Silbstep/Scale/Documents/LCD/AN 339 FT800 Single JPEG Viewer/Test/Glasgow.jpg

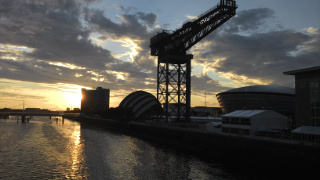
Documents/LCD/AN 339 FT800 Single JPEG Viewer/Test/Glasgow.jpg
