Silbstep/Scale/(list of files, cad)

Other CAD files:
Documents/LCD/ER-TFT035-6(8080-8-Bit)_TP_SD_DemoCode/sd.OBJ
