Silbstep/Scale/Documents/Ethernet/MI0805K601R-10.pdf

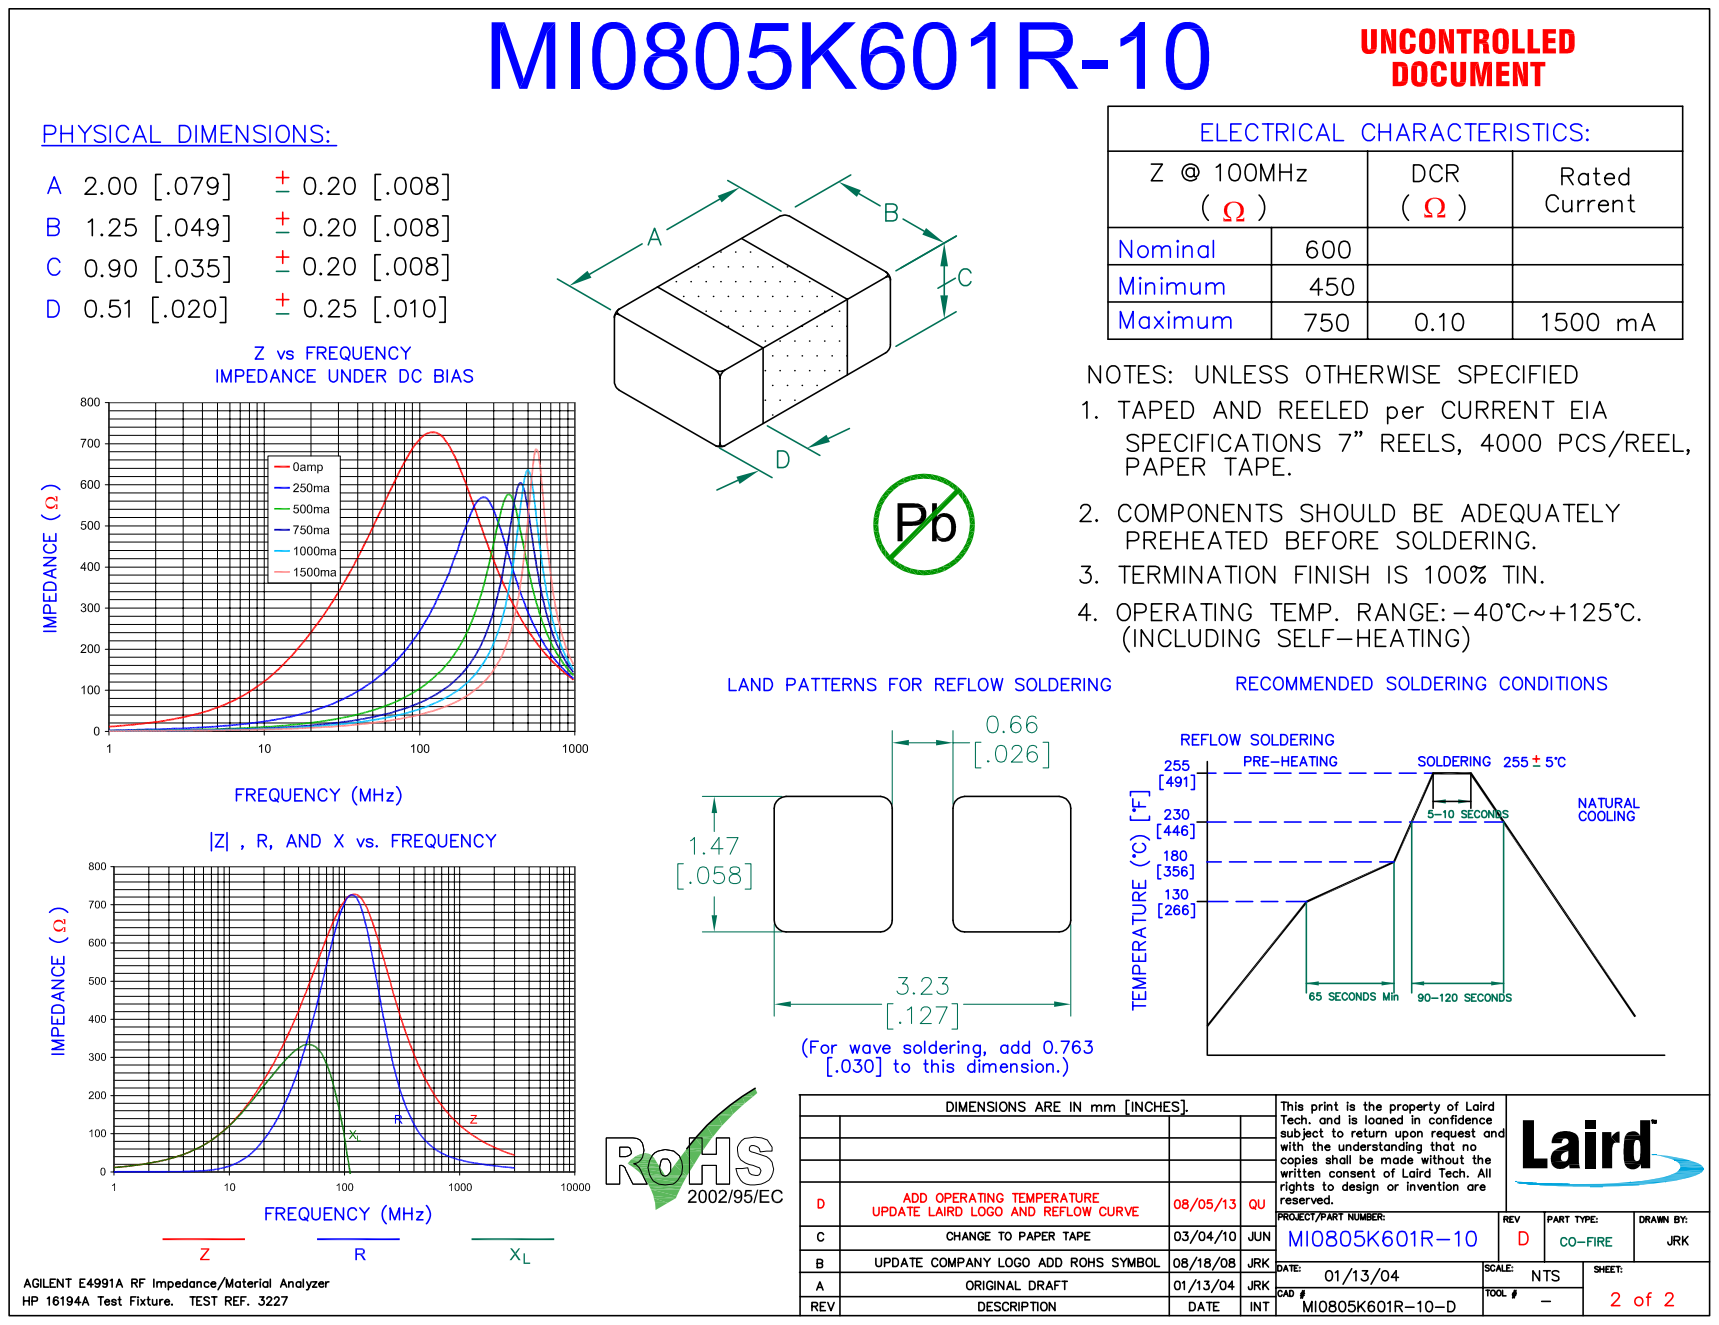
[picture p2: page 1]
