Silbstep/Scale/Documents/Ethernet/SI-16001-F.pdf

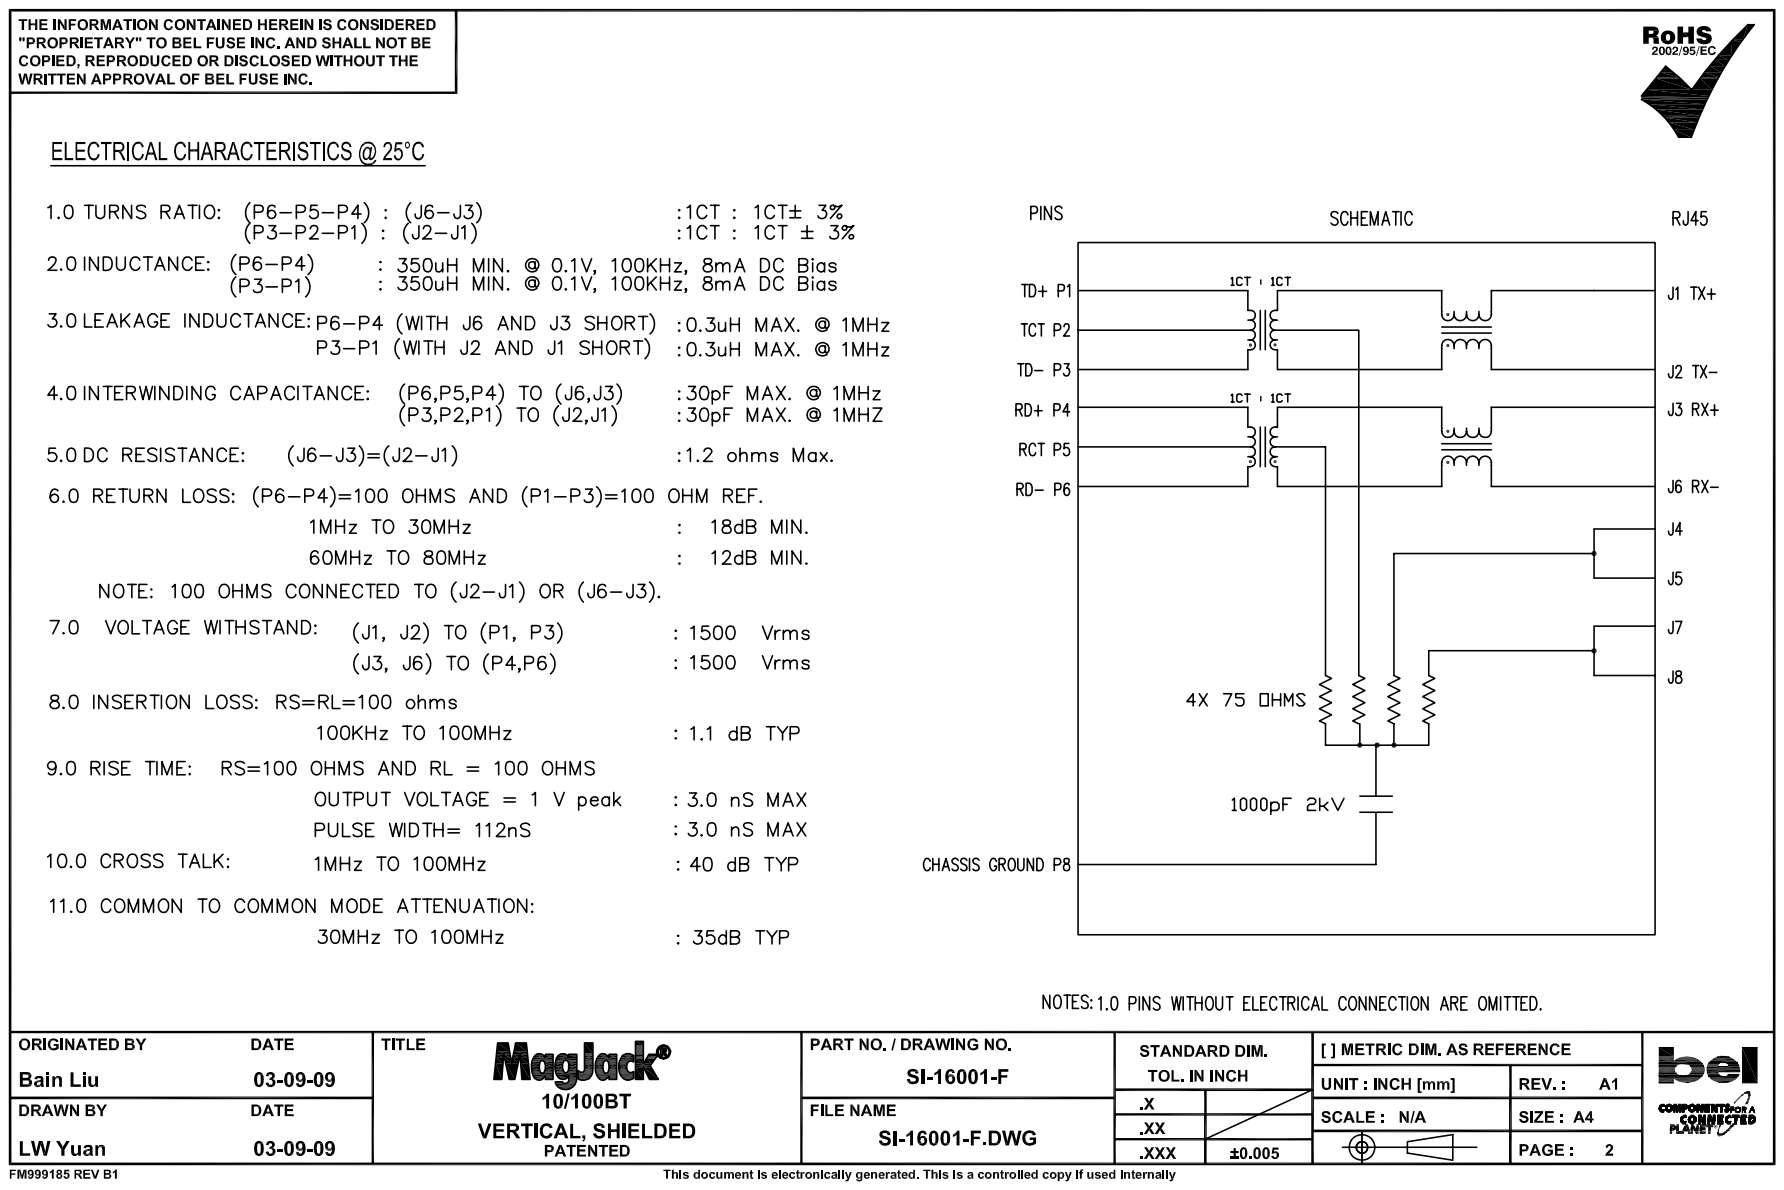
[picture p7: page 1]

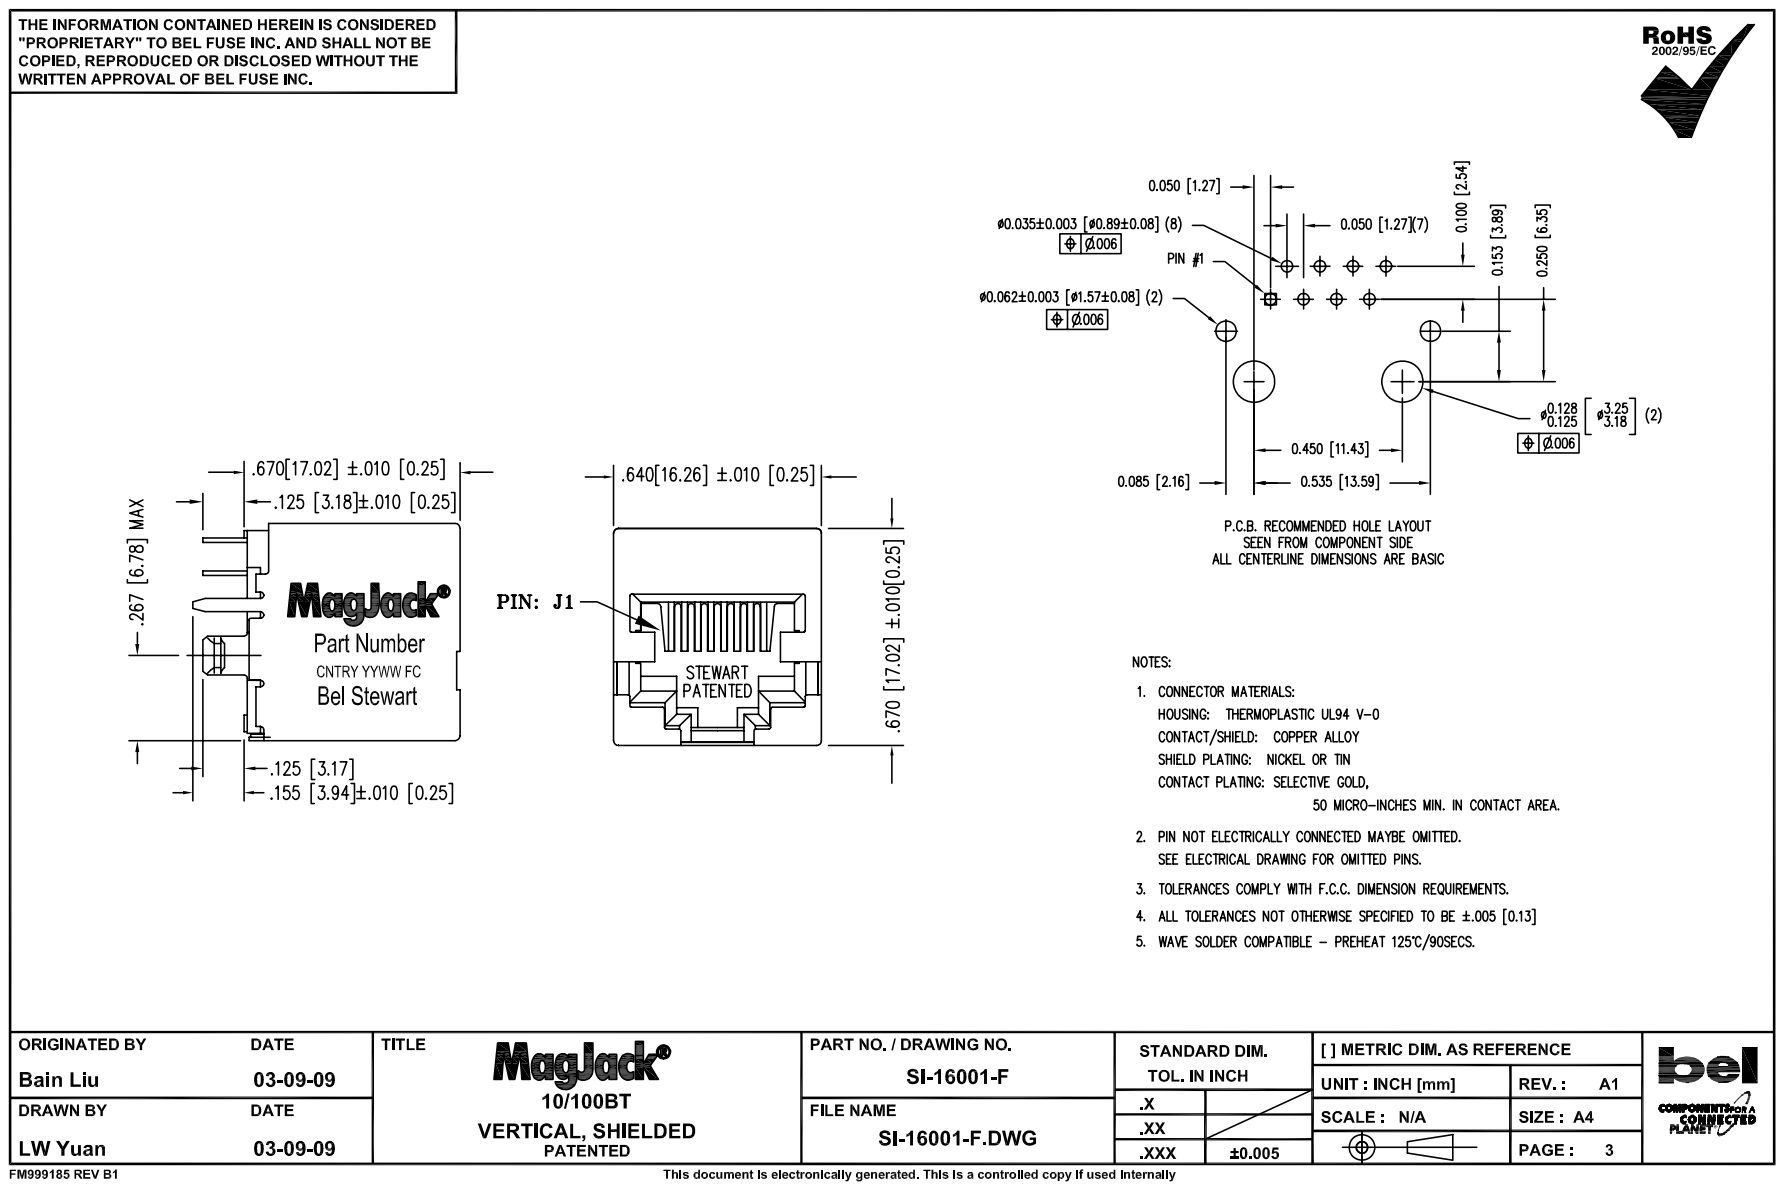
[picture p8: page 2]
