Silbstep/Scale/Hardware/Scale.kicad_pcb

## KiCad design Hardware/Scale.kicad_pcb (2023-03-06)

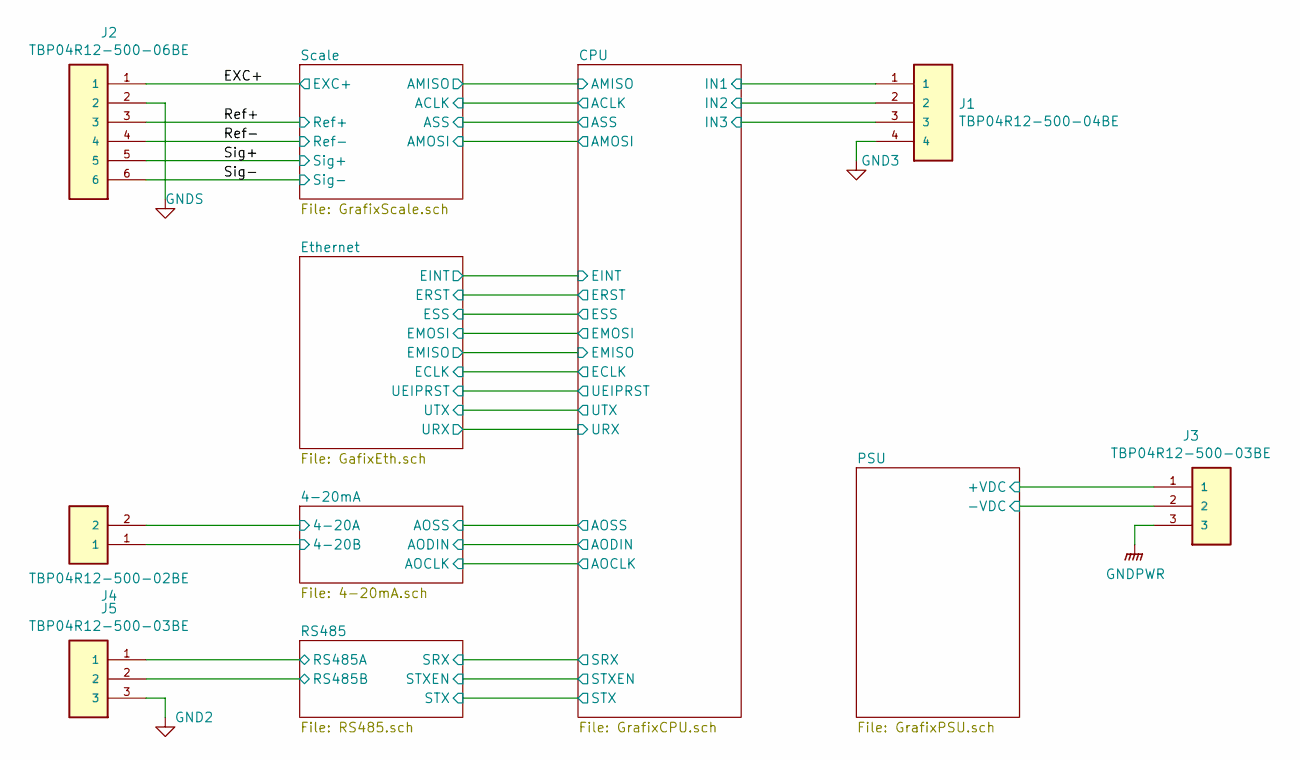
[picture p9: schematic Scale.sch]

Parts:
J1: TBP04R12-500-04BE; MPN TBP04R12-500-04BE
J2: TBP04R12-500-06BE; MPN TBP04R12-500-06BE
J3, J5: TBP04R12-500-03BE; MPN TBP04R12-500-03BE
J4: TBP04R12-500-02BE; MPN TBP04R12-500-02BE

Connections:
/4-20mA/4-20A: J4.2; also elsewhere on the board
/4-20mA/4-20B: J4.1; also elsewhere on the board
/CPU/IN1: J1.1; also elsewhere on the board
/CPU/IN2: J1.2; also elsewhere on the board
/CPU/IN3: J1.3; also elsewhere on the board
/EXC+: J2.1; also elsewhere on the board
/PSU/+VDC: J3.1; also elsewhere on the board
/PSU/-VDC: J3.2; also elsewhere on the board
/RS485/RS485A: J5.1; also elsewhere on the board
/RS485/RS485B: J5.2; also elsewhere on the board
/Ref+: J2.3; also elsewhere on the board
/Ref-: J2.4; also elsewhere on the board
/Sig+: J2.5; also elsewhere on the board
/Sig-: J2.6; also elsewhere on the board
GND2: J5.3; also elsewhere on the board
GND3: J1.4; also elsewhere on the board
GNDPWR: J3.3; also elsewhere on the board
GNDS: J2.2; also elsewhere on the board

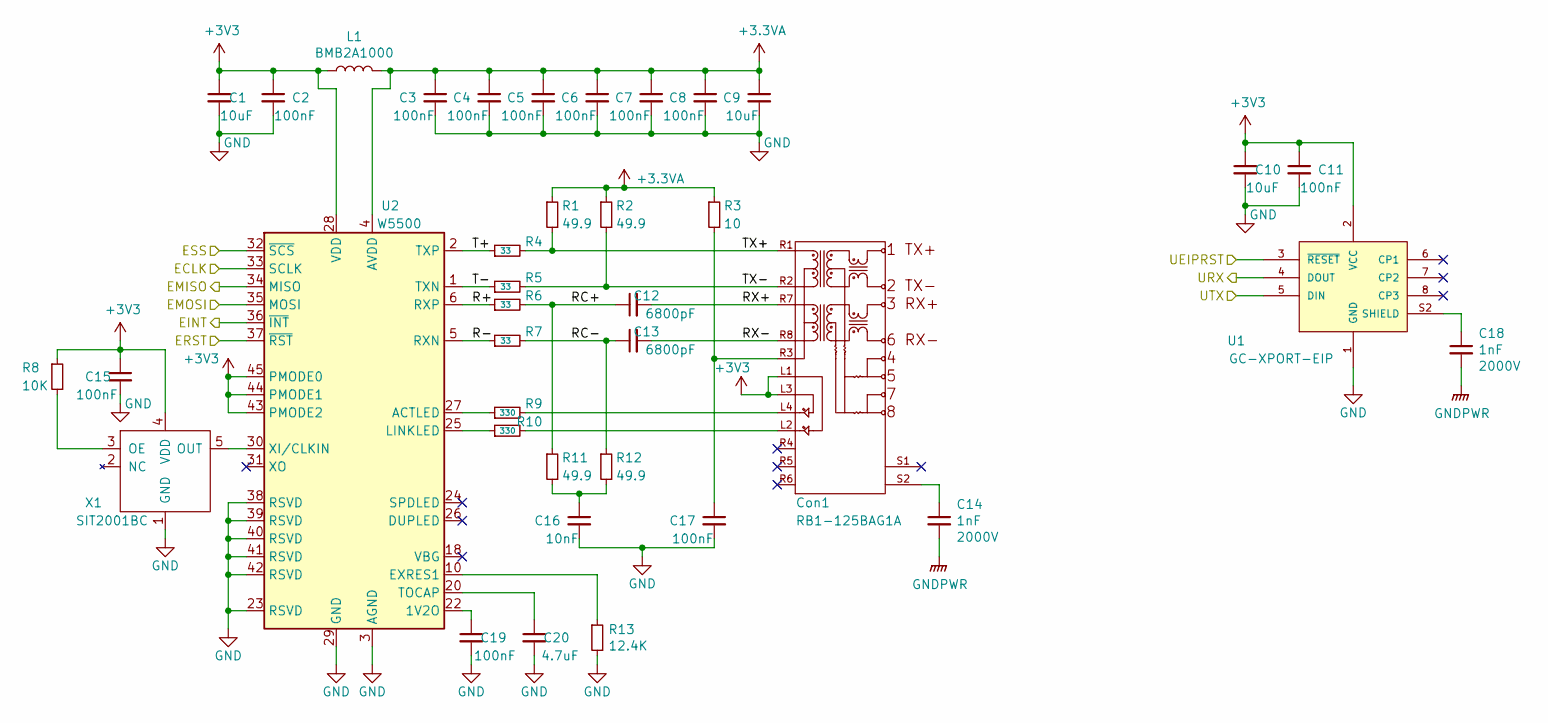
[picture p10: schematic GafixEth.sch]

Parts:
C1, C9, C10: 10uF; C_0603_1608Metric
C2, C3, C4, C5, C6, C7, C8, C11, C15, C17, C19: 100nF; C_0603_1608Metric
C12, C13: 6800pF; C_0603_1608Metric
C14, C18: 1nF; C_1206_3216Metric
C16: 10nF; C_0603_1608Metric
C20: 4.7uF; C_0603_1608Metric
Con1: RB1-125BAG1A; MPN RB1-125BAG1A
L1: BMB2A1000; L_0805_2012Metric; MPN BMB2A1000LN2
R1, R2, R11, R12: 49.9; R_0603_1608Metric
R3: 10; R_0603_1608Metric
R4, R5, R6, R7: 33; R_0603_1608Metric
R8: 10K; R_0603_1608Metric
R9, R10: 330; R_0603_1608Metric
R13: 12.4K; R_0603_1608Metric
U1: GC-XPORT-EIP; XPORT; MPN GC-XPORT-EIP-MB
U2: W5500; MPN W5500
X1: SIT2001BC; SOT-753; MPN SIT2001BC-S2-33E-25.000000

Connections:
+3.3VA: C3.1, C4.1, C5.1, C6.1, C7.1, C8.1, C9.1, L1.2, R1.1, R2.1, R3.1, U2.4 (AVDD), U2.8 (AVDD), U2.11 (AVDD), U2.15 (AVDD), U2.17 (AVDD), U2.21 (AVDD)
/CPU/ECLK: U2.33 (SCLK); also elsewhere on the board
/CPU/EINT: U2.36 (~INT); also elsewhere on the board
/CPU/EMISO: U2.34 (MISO); also elsewhere on the board
/CPU/EMOSI: U2.35 (MOSI); also elsewhere on the board
/CPU/ERST: U2.37 (~RST); also elsewhere on the board
/CPU/ESS: U2.32 (~SCS); also elsewhere on the board
/CPU/UEIPRST: U1.3 (~RESET); also elsewhere on the board
/CPU/URX: U1.4 (DOUT); also elsewhere on the board
/CPU/UTX: U1.5 (DIN); also elsewhere on the board
/Ethernet/R+: R6.1, U2.6 (RXP)
/Ethernet/R-: R7.1, U2.5 (RXN)
/Ethernet/RC+: C12.1, R6.2, R11.1
/Ethernet/RC-: C13.1, R7.2, R12.1
/Ethernet/RX+: C12.2, Con1.R7
/Ethernet/RX-: C13.2, Con1.R8
/Ethernet/T+: R4.1, U2.2 (TXP)
/Ethernet/T-: R5.1, U2.1 (TXN)
/Ethernet/TX+: Con1.R1, R1.2, R4.2
/Ethernet/TX-: Con1.R2, R2.2, R5.2
GND: C1.2, C2.2, C3.2, C4.2, C5.2, C6.2, C7.2, C8.2, C9.2, C10.2, C11.2, C15.2, C16.2, C17.2, C19.2, C20.2, R13.2, U1.1 (GND), U2.3 (AGND), U2.9 (AGND), U2.14 (AGND), U2.16 (AGND), U2.19 (AGND), U2.23 (RSVD), U2.29 (GND), U2.38 (RSVD), U2.39 (RSVD), U2.40 (RSVD), U2.41 (RSVD), U2.42 (RSVD), U2.48 (AGND), X1.1 (GND); also elsewhere on the board
GNDPWR: C14.2, C18.2; also elsewhere on the board
unnamed: C14.1, Con1.S2
unnamed: C16.1, R11.2, R12.2
unnamed: C17.1, Con1.R3, R3.2
unnamed: C18.1, U1.S2 (SHIELD)
unnamed: C19.1, U2.22 (1V2O)
unnamed: C20.1, U2.20 (TOCAP)
unnamed: Con1.L2, R10.2
unnamed: Con1.L4, R9.2
unnamed: R8.2, X1.3 (OE)
unnamed: R9.1, U2.27 (ACTLED)
unnamed: R10.1, U2.25 (LINKLED)
unnamed: R13.1, U2.10 (EXRES1)
unnamed: U2.30 (XI/CLKIN), X1.5 (OUT)

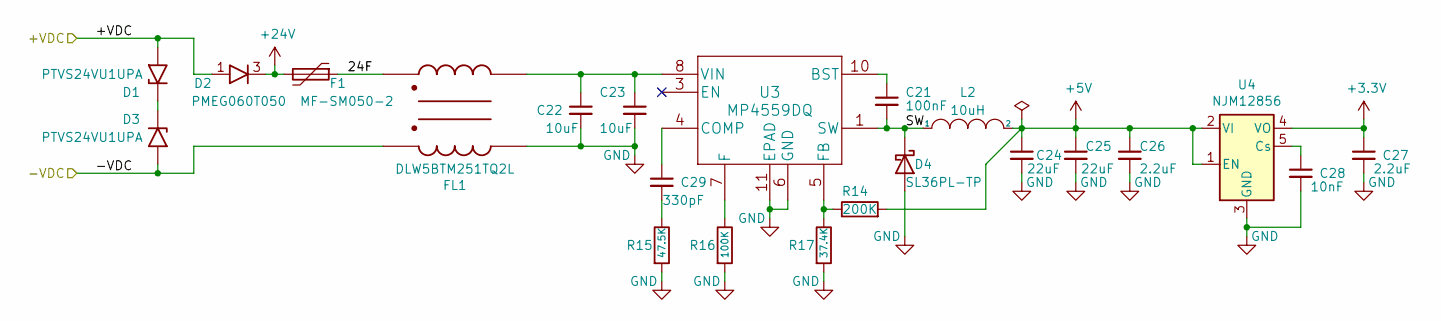
[picture p11: schematic GrafixPSU.sch]

Parts:
C21: 100nF; C_0603_1608Metric
C22, C23: 10uF; C_1206_3216Metric; MPN CL31B106KBHNNNE
C24, C25: 22uF; C_1206_3216Metric
C26, C27: 2.2uF; C_0603_1608Metric
C28: 10nF; C_0603_1608Metric
C29: 330pF; C_0603_1608Metric
D1, D3: PTVS24VU1UPA; PTVS10VU1UPAZ; MPN PTVS24VU1UPAZ
D2: PMEG060T050; TO-277; MPN PMEG060T050ELPEZ
D4: SL36PL-TP; SOD123-FL; MPN SL36PL-TP
F1: MF-SM050-2; MF-SM050; MPN MF-SM050-2
FL1: DLW5BTM251TQ2L; MPN DLW5BTM251TQ2L
L2: 10uH; MPL-SE6040; MPN MPL-SE6040-100
R14: 200K; R_0603_1608Metric
R15: 47.5K; R_0603_1608Metric
R16: 100K; R_0603_1608Metric
R17: 37.4K; R_0603_1608Metric
U3: MP4559DQ; DFN-10-1EP_3x3mm_P0.5mm_EP1.7x2.5mm; MPN MP4559DQ-LF-Z
U4: NJM12856; TO-252-5_TabPin6; MPN NJM12856DL3-33-TE1

Connections:
+5V: C24.1, C25.1, C26.1, L2.2, R14.2, U4.1 (EN), U4.2 (VI); also elsewhere on the board
+24V: D2.3 (K), F1.2
/PSU/24F: F1.1, FL1.4
/PSU/+VDC: D1.1 (A1), D1.2 (A2), D2.1 (A), D2.2 (A); also elsewhere on the board
/PSU/-VDC: D3.1 (A1), D3.2 (A2), FL1.1; also elsewhere on the board
GND: C22.2, C23.2, C24.2, C25.2, C26.2, C27.2, C28.2, D4.2 (A), FL1.2, R15.2, R16.2, R17.2, U3.6 (GND), U3.11 (EPAD), U4.3 (GND), U4.6 (GND); also elsewhere on the board
unnamed: C21.1, U3.10 (BST)
unnamed: C28.1, U4.5 (Cs)
unnamed: C29.1, U3.4 (COMP)
unnamed: C29.2, R15.1
unnamed: D1.3 (K1), D1.4 (K2), D3.3 (K1), D3.4 (K2)
unnamed: R14.1, R17.1, U3.5 (FB)
unnamed: R16.1, U3.7 (F)
SW: C21.2, D4.1 (K), L2.1, U3.1 (SW), U3.2 (SW)
VIN: C22.1, C23.1, FL1.3, U3.8 (VIN), U3.9 (VIN)

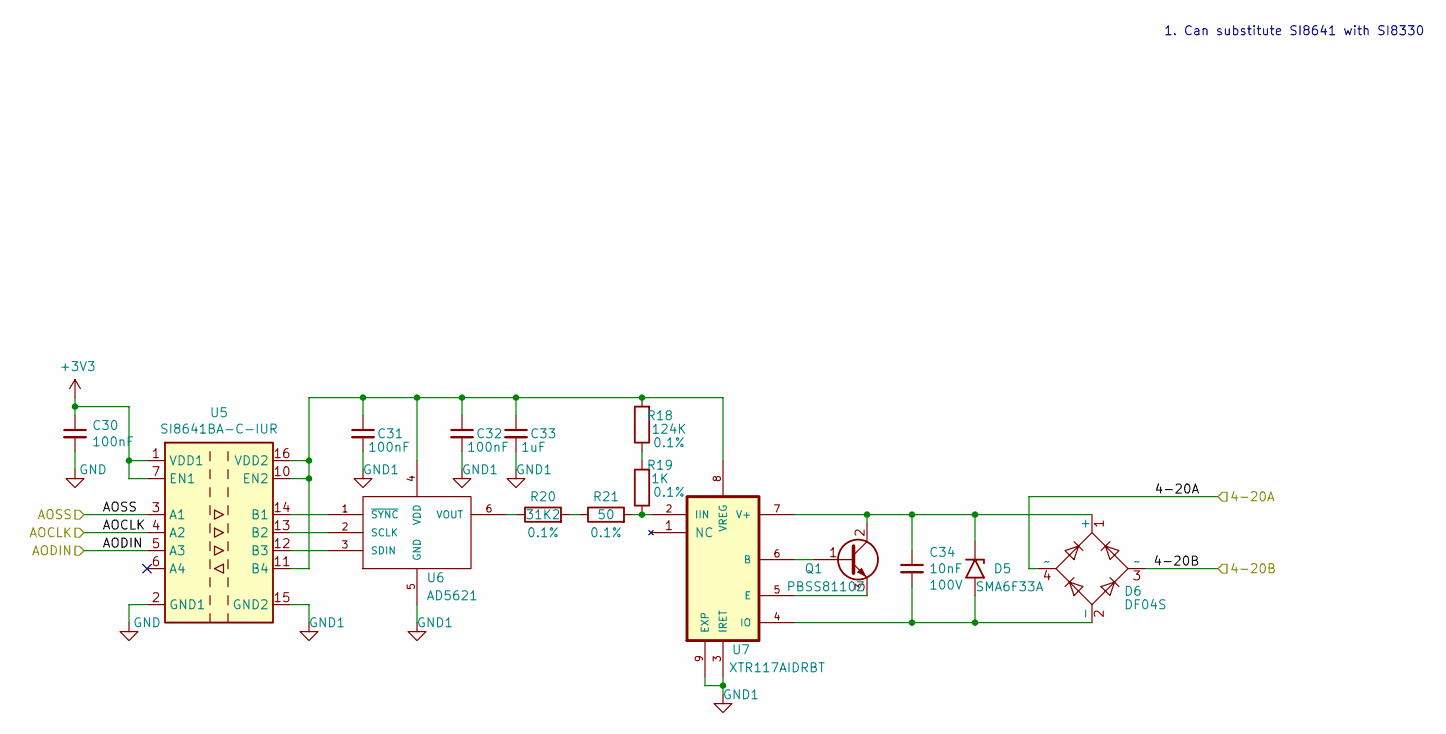
[picture p12: schematic 4-20mA.sch]

Parts:
C30, C31, C32: 100nF; C_0603_1608Metric
C33: 1uF; C_0603_1608Metric
C34: 10nF; C_0805_2012Metric; Voltage 100V
D5: SMA6F33A; DO221AC; MPN SMA6F33A-M3/H
D6: DF04S; MPN DF04S
Q1: PBSS8110Z; SOT-223; MPN PBSS8110Z,135
R18: 124K; R_0603_1608Metric; Tolerance 0.1%
R19: 1K; R_0603_1608Metric; Tolerance 0.1%
R20: 31K2; R_0603_1608Metric; Tolerance 0.1%
R21: 50; R_0603_1608Metric; Tolerance 0.1%
U5: SI8641BA-C-IUR; QSOP-16_3.9x4.9mm_P0.635mm; MPN SI8641BA-C-IUR
U6: AD5621; SOT-363_SC-70-6; MPN AD5621AKSZ-REEL7
U7: XTR117AIDRBT; XTR117AID; MPN XTR117AIDRBT

Connections:
/4-20mA/4-20A: D6.4 (~~); also elsewhere on the board
/4-20mA/4-20B: D6.3 (~~); also elsewhere on the board
/4-20mA/AOCLK: U5.4 (A2); also elsewhere on the board
/4-20mA/AODIN: U5.5 (A3); also elsewhere on the board
/4-20mA/AOSS: U5.3 (A1); also elsewhere on the board
GND: C30.2, U5.2 (GND1), U5.8 (GND1); also elsewhere on the board
GND1: C31.2, C32.2, C33.2, U5.9 (GND2), U5.15 (GND2), U6.5 (GND), U7.3 (IRET), U7.9 (EXP)
unnamed: C31.1, C32.1, C33.1, R18.2, U5.10 (EN2), U5.11 (B4), U5.16 (VDD2), U6.4 (VDD), U7.8 (VREG)
unnamed: C34.1, D5.1 (A1), D6.1 (+), Q1.2 (C), Q1.4 (C), U7.7 (V+)
unnamed: C34.2, D5.2 (A2), D6.2 (-), U7.4 (IO)
unnamed: Q1.1 (B), U7.6 (B)
unnamed: Q1.3 (E), U7.5 (E)
unnamed: R18.1, R19.2
unnamed: R19.1, R21.2, U7.2 (IIN)
unnamed: R20.1, U6.6 (VOUT)
unnamed: R20.2, R21.1
unnamed: U5.12 (B3), U6.3 (SDIN)
unnamed: U5.13 (B2), U6.2 (SCLK)
unnamed: U5.14 (B1), U6.1 (~SYNC)

Notes on the sheet:
1. Can substitute SI8641 with SI8330

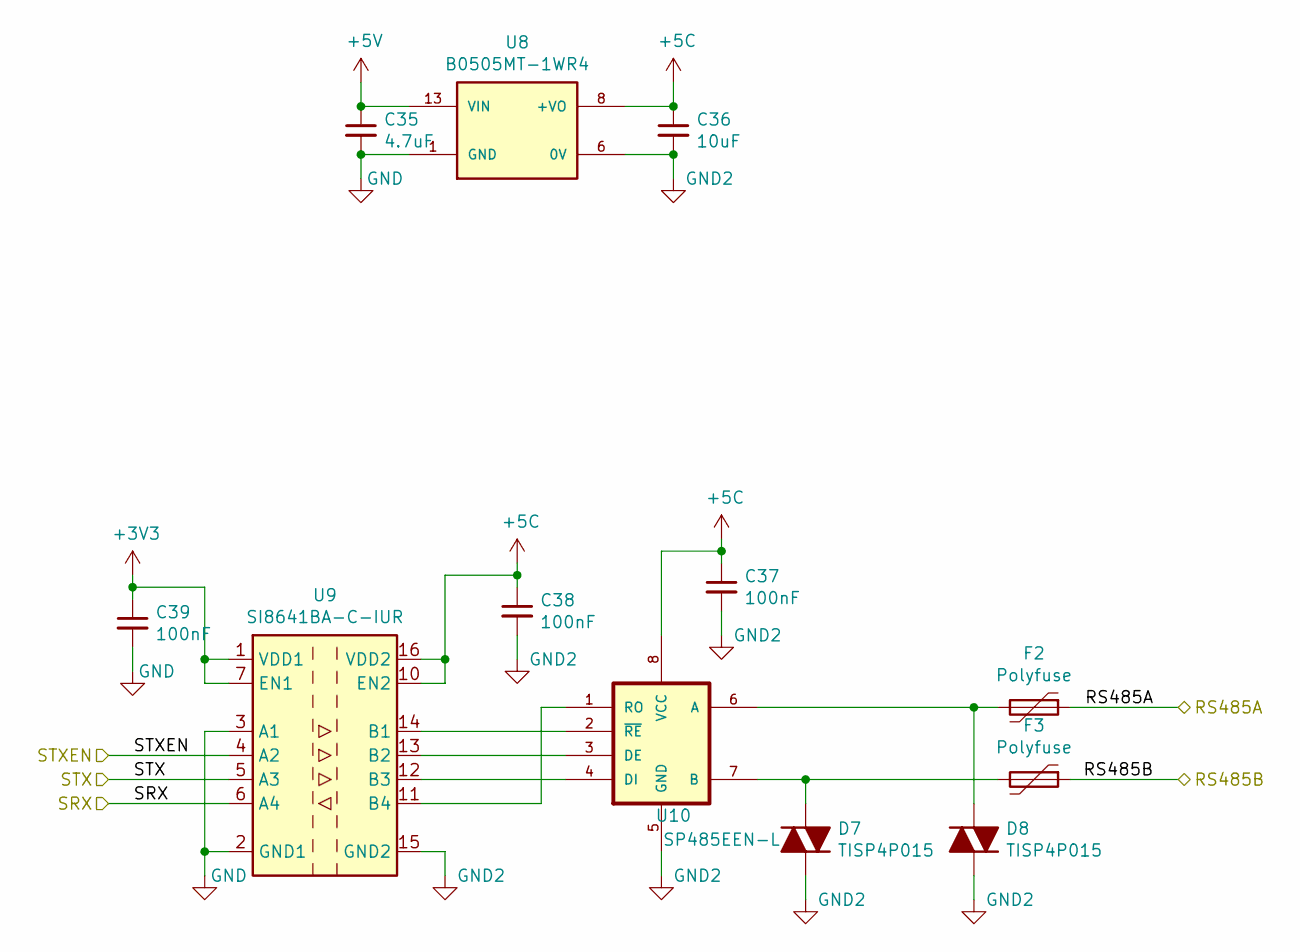
[picture p13: schematic RS485.sch]

Parts:
C35: 4.7uF; C_0603_1608Metric
C36: 10uF; C_0603_1608Metric
C37, C38, C39: 100nF; C_0603_1608Metric
D7, D8: TISP4P015; SOT-23-5; MPN TISP4P015L1NR-S
F2, F3: Polyfuse; Fuse_1206_3216Metric; MPN PTS120660V010
U8: B0505MT-1WR4; MPN B0505MT-1WR4
U9: SI8641BA-C-IUR; QSOP-16_3.9x4.9mm_P0.635mm; MPN SI8641BA-C-IUR
U10: SP485EEN-L; SOIC-8_3.9x4.9mm_P1.27mm; MPN SP485EEN-L

Connections:
+5C: C36.1, C37.1, C38.1, U8.8 (+VO), U9.10 (EN2), U9.16 (VDD2), U10.8 (VCC)
+5V: C35.1, U8.13 (VIN), U8.14 (VIN); also elsewhere on the board
/CPU/SRX: U9.6 (A4); also elsewhere on the board
/CPU/STX: U9.5 (A3); also elsewhere on the board
/CPU/STXEN: U9.4 (A2); also elsewhere on the board
/RS485/RS485A: F2.1; also elsewhere on the board
/RS485/RS485B: F3.1; also elsewhere on the board
GND: C35.2, C39.2, U8.1 (GND), U8.2 (GND), U9.2 (GND1), U9.3 (A1), U9.8 (GND1); also elsewhere on the board
GND2: C36.2, C37.2, C38.2, D7.3, D7.4, D8.3, D8.4, U8.6 (0V), U8.7 (0V), U9.9 (GND2), U9.15 (GND2), U10.5 (GND); also elsewhere on the board
unnamed: D7.1, D7.5, F3.2, U10.7 (B)
unnamed: D8.1, D8.5, F2.2, U10.6 (A)
unnamed: U9.11 (B4), U10.1 (RO)
unnamed: U9.14 (B1), U10.2 (~RE)
unnamed: U9.13 (B2), U10.3 (DE)
unnamed: U9.12 (B3), U10.4 (DI)

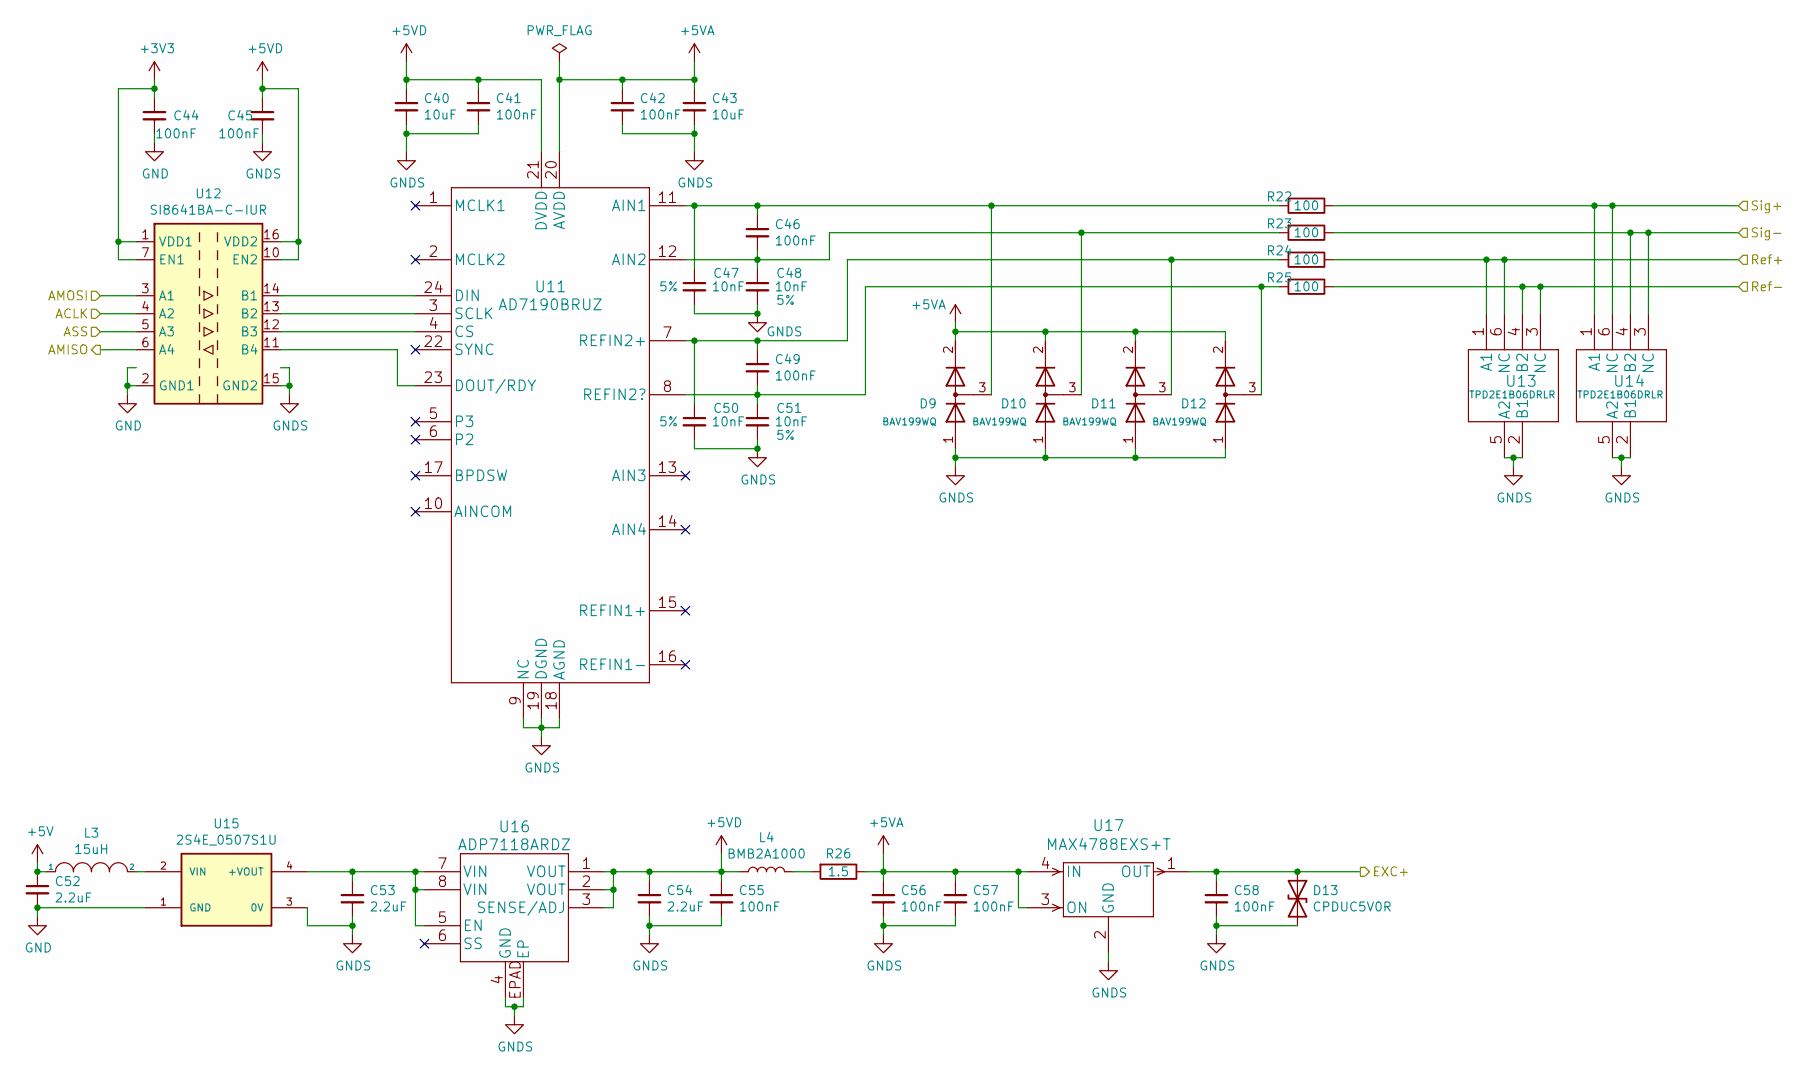
[picture p14: schematic GrafixScale.sch]

Parts:
C40: 10uF; C_0805_2012MetricSpecial; MPN LMK212BJ106KD-T
C41, C42, C44, C45, C46, C49, C55, C56, C57, C58: 100nF; C_0603_1608Metric
C43: 10uF; C_0805_2012Metric; MPN LMK212BJ106KD-T
C47, C48, C50, C51: 10nF; C_0603_1608Metric
C52, C53, C54: 2.2uF; C_0603_1608Metric
D9, D10, D11, D12: BAV199WQ; SOT-323_SC-70; MPN BAV199WQ
D13: CPDUC5V0R; D_0603_1608Metric; MPN CPDUC5V0R-HF
L3: 15uH; SDED20161T; MPN Delta Electronics/Cyntec
L4: BMB2A1000; L_0805_2012Metric; MPN BMB2A1000LN2
R22, R23, R24, R25: 100; R_1206_3216Metric
R26: 1.5; R_0805_2012Metric
U11: AD7190BRUZ; MPN AD7190BRUZ
U12: SI8641BA-C-IUR; QSOP-16_3.9x4.9mm_P0.635mm; MPN SI8641BA-C-IUR
U13, U14: TPD2E1B06DRLR; MPN TPD2E1B06DRLR
U15: 2S4E_0507S1U; AM1S-0507SZ; MPN 2S4E_0507S1U
U16: ADP7118ARDZ; MPN ADP7118ARDZ-5.0
U17: MAX4788EXS+T; MAX4788; MPN MAX4788EXS+T

Connections:
+5V: C52.1, L3.1; also elsewhere on the board
+5VA: C42.1, C43.1, C56.1, C57.1, D9.2 (K2), D10.2 (K2), D11.2 (K2), D12.2 (K2), R26.1, U11.20 (AVDD), U17.3 (ON), U17.4 (IN)
+5VD: C40.1, C41.1, C45.1, C54.1, C55.1, L4.1, U11.21 (DVDD), U12.10 (EN2), U12.16 (VDD2), U16.1 (VOUT), U16.2 (VOUT), U16.3 (SENSE/ADJ)
/CPU/ACLK: U12.4 (A2); also elsewhere on the board
/CPU/AMISO: U12.6 (A4); also elsewhere on the board
/CPU/AMOSI: U12.3 (A1); also elsewhere on the board
/CPU/ASS: U12.5 (A3); also elsewhere on the board
/EXC+: C58.1, D13.1 (A1), U17.1 (OUT); also elsewhere on the board
/Ref+: R24.1, U13.1 (A1), U13.6 (NC); also elsewhere on the board
/Ref-: R25.1, U13.3 (NC), U13.4 (B2); also elsewhere on the board
/Sig+: R22.1, U14.1 (A1), U14.6 (NC); also elsewhere on the board
/Sig-: R23.1, U14.3 (NC), U14.4 (B2); also elsewhere on the board
GND: C44.2, C52.2, U12.2 (GND1), U12.8 (GND1), U15.1 (GND); also elsewhere on the board
GNDS: C40.2, C41.2, C42.2, C43.2, C45.2, C47.2, C48.2, C50.2, C51.2, C53.2, C54.2, C55.2, C56.2, C57.2, C58.2, D9.1 (A1), D10.1 (A1), D11.1 (A1), D12.1 (A1), D13.2 (A2), U11.9 (NC), U11.18 (AGND), U11.19 (DGND), U12.9 (GND2), U12.15 (GND2), U13.2 (B1), U13.5 (A2), U14.2 (B1), U14.5 (A2), U15.3 (0V), U16.4 (GND), U16.EPAD (EP), U17.2 (GND); also elsewhere on the board
unnamed: C46.1, C47.1, D9.3 (K3A4), R22.2, U11.11 (AIN1)
unnamed: C46.2, C48.1, D10.3 (K3A4), R23.2, U11.12 (AIN2)
unnamed: C49.1, C50.1, D11.3 (K3A4), R24.2, U11.7 (REFIN2+)
unnamed: C49.2, C51.1, D12.3 (K3A4), R25.2, U11.8 (REFIN2?)
unnamed: C53.1, U15.4 (+VOUT), U16.5 (EN), U16.7 (VIN), U16.8 (VIN)
unnamed: L3.2, U15.2 (VIN)
unnamed: L4.2, R26.2
unnamed: U11.3 (SCLK), U12.13 (B2)
unnamed: U11.4 (CS), U12.12 (B3)
unnamed: U11.23 (DOUT/RDY), U12.11 (B4)
unnamed: U11.24 (DIN), U12.14 (B1)

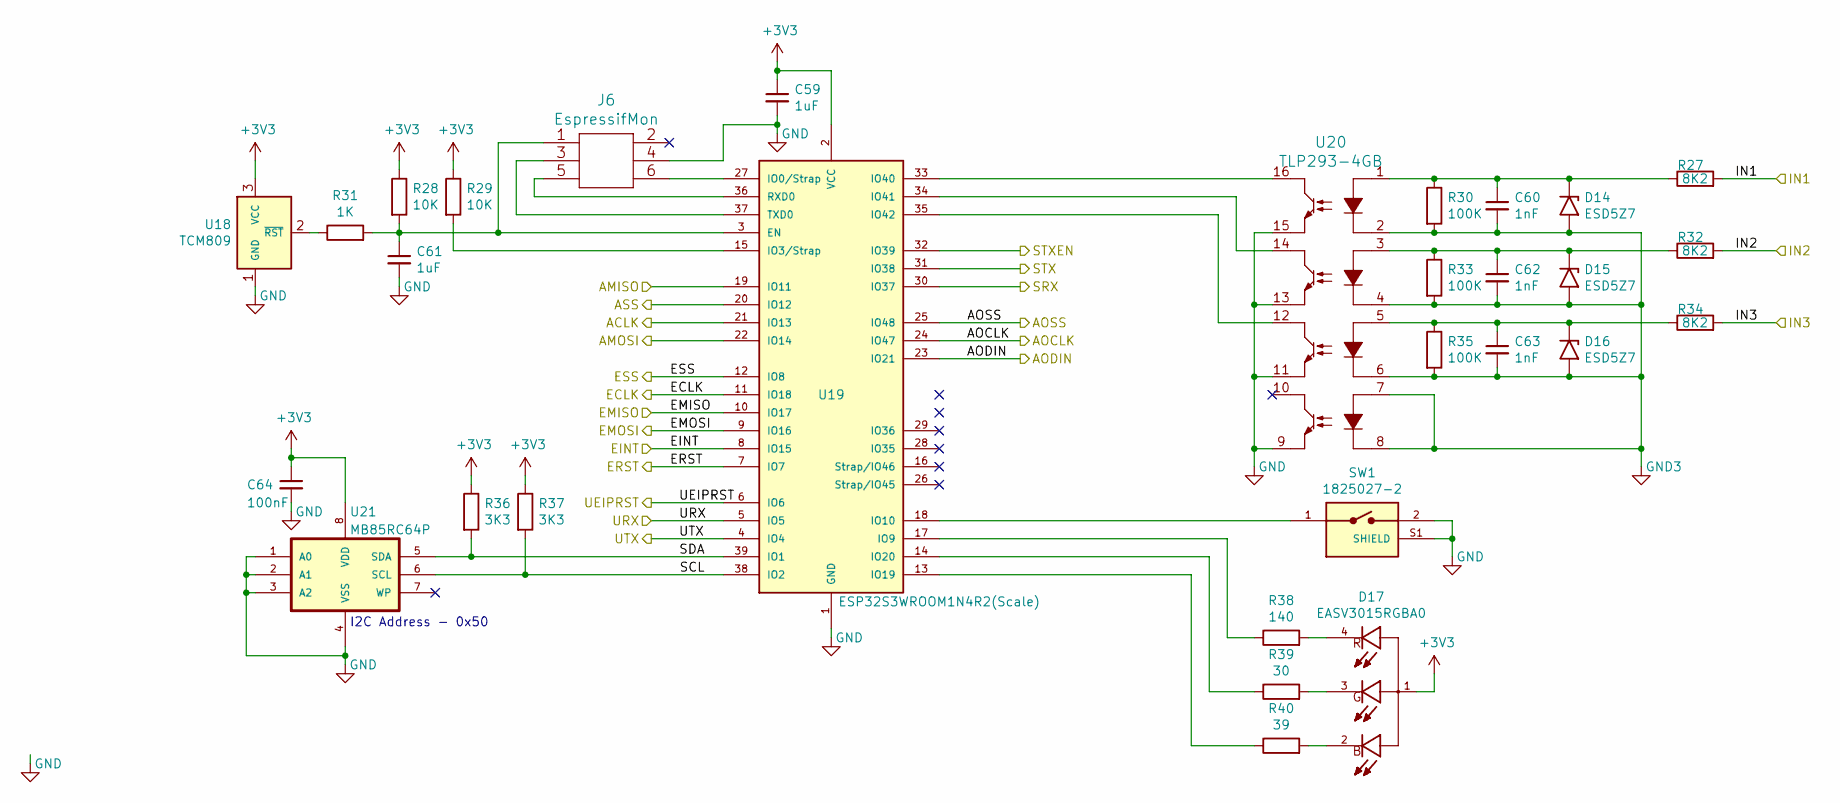
[picture p15: schematic GrafixCPU.sch]

Parts:
C59, C61: 1uF; C_0603_1608Metric
C60, C62, C63: 1nF; C_0603_1608Metric
C64: 100nF; C_0603_1608Metric
D14, D15, D16: ESD5Z7; D_SOD-523; MPN ESD5Z7.0T1G
D17: EASV3015RGBA0; LED_EASV3015RGBA0; MPN EASV3015RGBA0
J6: EspressifMon; 3220-06-0100-00; MPN PR20B03VBDN
R27, R32, R34: 8K2; R_1206_3216Metric
R28, R29: 10K; R_0603_1608Metric
R30, R33, R35: 100K; R_0603_1608Metric
R31: 1K; R_0603_1608Metric
R36, R37: 3K3; R_0603_1608Metric
R38: 140; R_0603_1608Metric
R39: 30; R_0603_1608Metric
R40: 39; R_0603_1608Metric
SW1: 1825027-2; MPN 1825027-2
U18: TCM809; SOT-23; MPN APX809S05-29SA-7
U19: ESP32S3WROOM1N4R2(Scale); ESP32S3WROOM1N8R8; MPN ESP32-S3-WROOM-1-N4R2
U20: TLP293-4GB; MPN TLP293-4(GB,E
U21: MB85RC64P; SOIC-8_3.9x4.9mm_P1.27mm; MPN MB85RC64PNF-G-JNE1

Connections:
/4-20mA/AOCLK: U19.24 (IO47); also elsewhere on the board
/4-20mA/AODIN: U19.23 (IO21); also elsewhere on the board
/4-20mA/AOSS: U19.25 (IO48); also elsewhere on the board
/CPU/ACLK: U19.21 (IO13); also elsewhere on the board
/CPU/AMISO: U19.19 (IO11); also elsewhere on the board
/CPU/AMOSI: U19.22 (IO14); also elsewhere on the board
/CPU/ASS: U19.20 (IO12); also elsewhere on the board
/CPU/ECLK: U19.11 (IO18); also elsewhere on the board
/CPU/EINT: U19.8 (IO15); also elsewhere on the board
/CPU/EMISO: U19.10 (IO17); also elsewhere on the board
/CPU/EMOSI: U19.9 (IO16); also elsewhere on the board
/CPU/ERST: U19.7 (IO7); also elsewhere on the board
/CPU/ESS: U19.12 (IO8); also elsewhere on the board
/CPU/IN1: R27.2; also elsewhere on the board
/CPU/IN2: R32.2; also elsewhere on the board
/CPU/IN3: R34.2; also elsewhere on the board
/CPU/SCL: R37.2, U19.38 (IO2), U21.6 (SCL)
/CPU/SDA: R36.2, U19.39 (IO1), U21.5 (SDA)
/CPU/SRX: U19.30 (IO37); also elsewhere on the board
/CPU/STX: U19.31 (IO38); also elsewhere on the board
/CPU/STXEN: U19.32 (IO39); also elsewhere on the board
/CPU/UEIPRST: U19.6 (IO6); also elsewhere on the board
/CPU/URX: U19.5 (IO5); also elsewhere on the board
/CPU/UTX: U19.4 (IO4); also elsewhere on the board
GND: C59.2, C61.2, C64.2, J6.4, SW1.2, SW1.S1 (SHIELD), SW1.S2 (SHIELD), U18.1 (GND), U19.1 (GND), U19.40 (GND), U19.41_1 (GND), U19.41_2 (GND), U19.41_3 (GND), U19.41_4 (GND), U19.41_5 (GND), U19.41_6 (GND), U19.41_7 (GND), U19.41_8 (GND), U19.41_9 (GND), U20.9, U20.11, U20.13, U20.15, U21.1 (A0), U21.2 (A1), U21.3 (A2), U21.4 (VSS); also elsewhere on the board
GND3: C60.2, C62.2, C63.2, D14.2 (A2), D15.2 (A2), D16.2 (A2), R30.2, R33.2, R35.2, U20.2, U20.4, U20.6, U20.7, U20.8; also elsewhere on the board
unnamed: C60.1, D14.1 (A1), R27.1, R30.1, U20.1
unnamed: C61.1, J6.1, R28.2, R31.2, U19.3 (EN)
unnamed: C62.1, D15.1 (A1), R32.1, R33.1, U20.3
unnamed: C63.1, D16.1 (A1), R34.1, R35.1, U20.5
unnamed: D17.2, R40.2
unnamed: D17.3, R39.2
unnamed: D17.4, R38.2
unnamed: J6.3, U19.37 (TXD0)
unnamed: J6.5, U19.36 (RXD0)
unnamed: J6.6, U19.27 (IO0/Strap)
unnamed: R29.2, U19.15 (IO3/Strap)
unnamed: R31.1, U18.2 (~RST~)
unnamed: R38.1, U19.17 (IO9)
unnamed: R39.1, U19.14 (IO20)
unnamed: R40.1, U19.13 (IO19)
unnamed: SW1.1, U19.18 (IO10)
unnamed: U19.33 (IO40), U20.16
unnamed: U19.34 (IO41), U20.14
unnamed: U19.35 (IO42), U20.12

Notes on the sheet:
I2C Address - 0x50

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
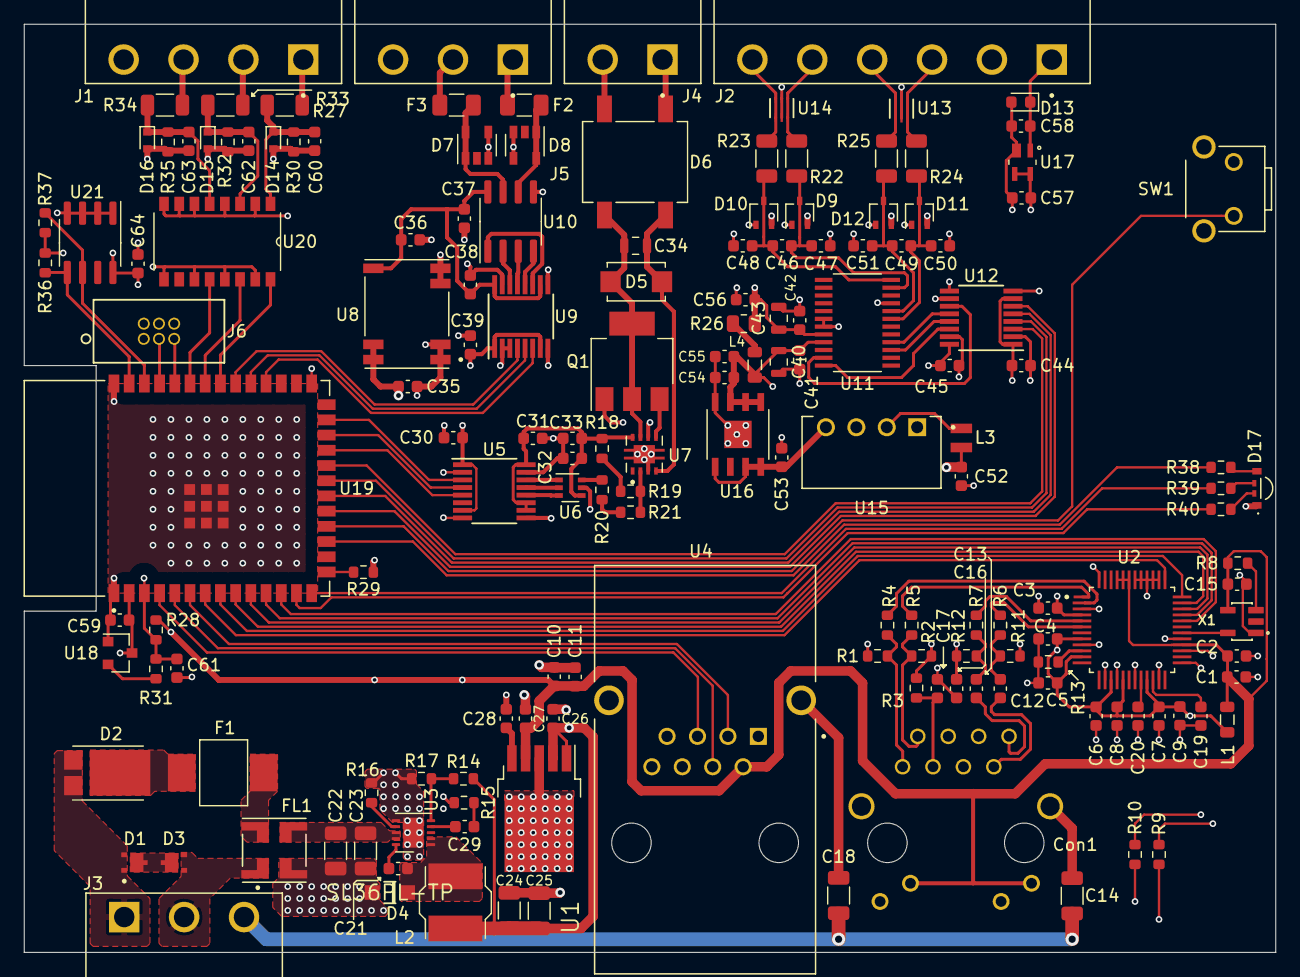
[picture p16: board Scale.kicad_pcb from above]

Board: 4 copper layers, 104.5 x 77.5 mm, 160 parts (0 on the bottom side), 129 nets.
